baileybdog110-beep/apple-watch-tamagotchi/images/back.png

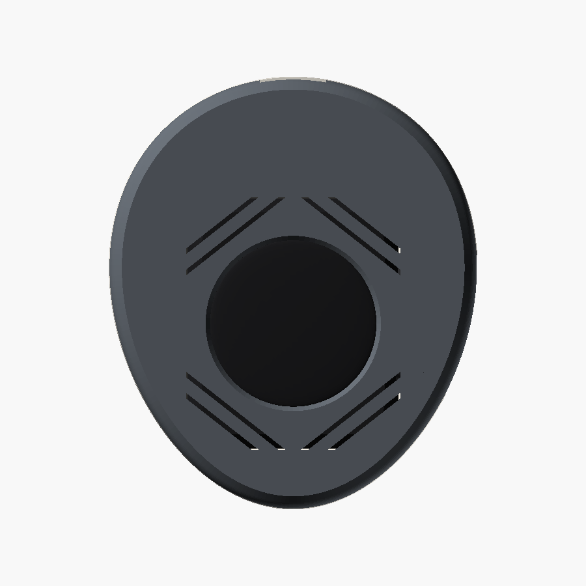
images/back.png
