baileybdog110-beep/apple-watch-tamagotchi/images/crown.png

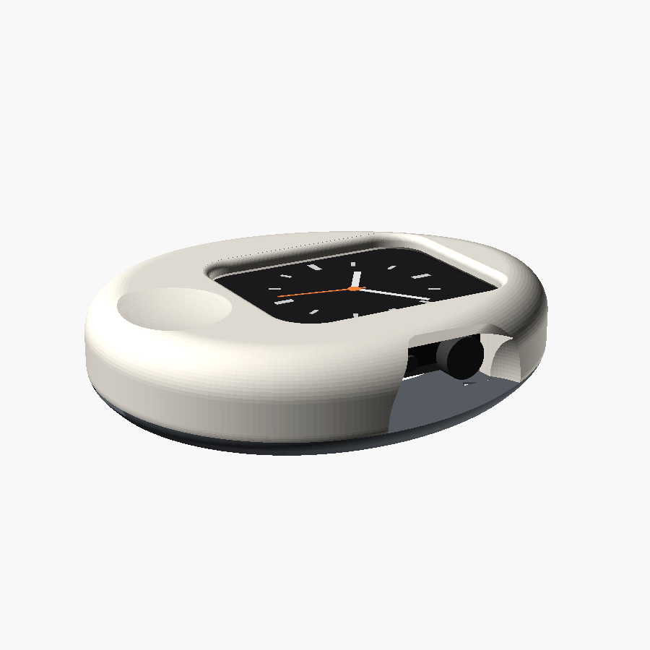
images/crown.png
