baileybdog110-beep/apple-watch-tamagotchi/images/exploded.png

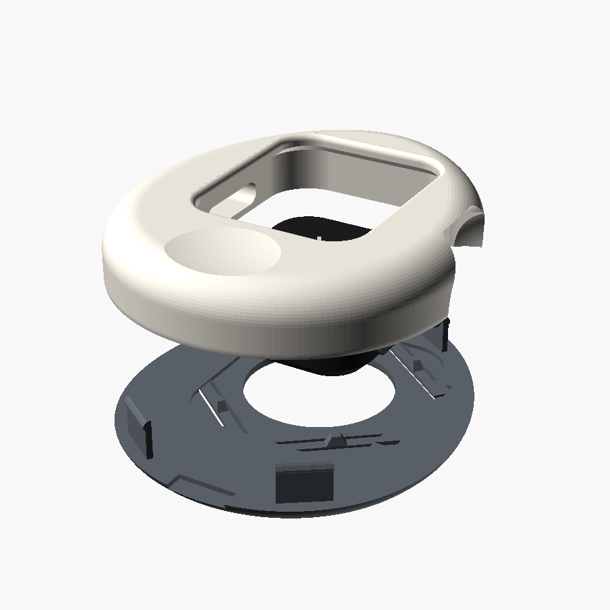
images/exploded.png
