baileybdog110-beep/apple-watch-tamagotchi/images/front.png

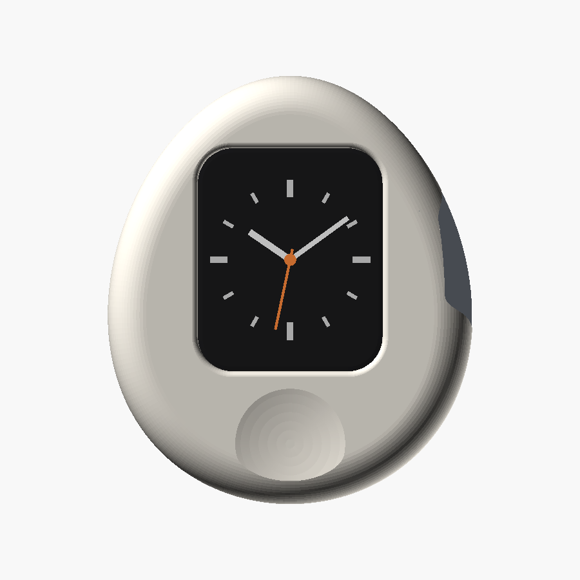
images/front.png
