baileybdog110-beep/apple-watch-tamagotchi/images/hero.png

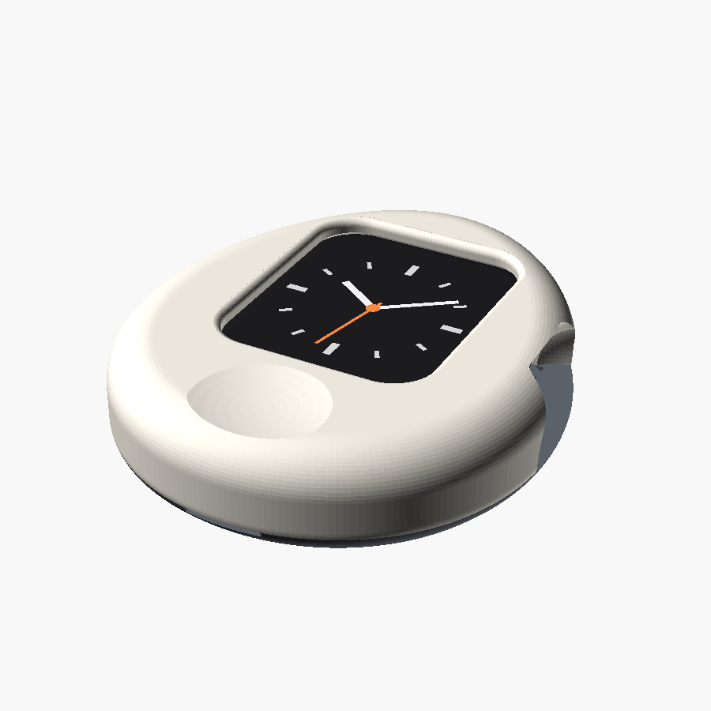
images/hero.png
