baileybdog110-beep/apple-watch-tamagotchi/images/profile.png

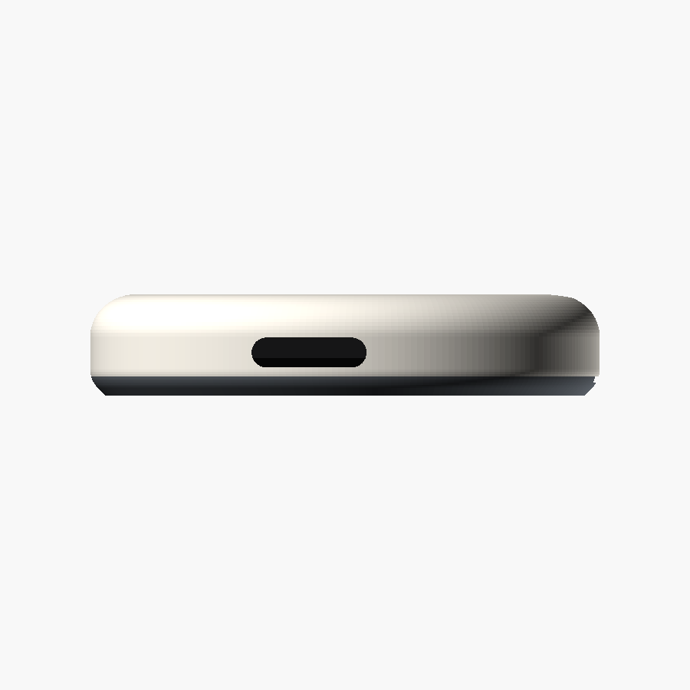
images/profile.png
