baileybdog110-beep/apple-watch-tamagotchi/images/sections.png

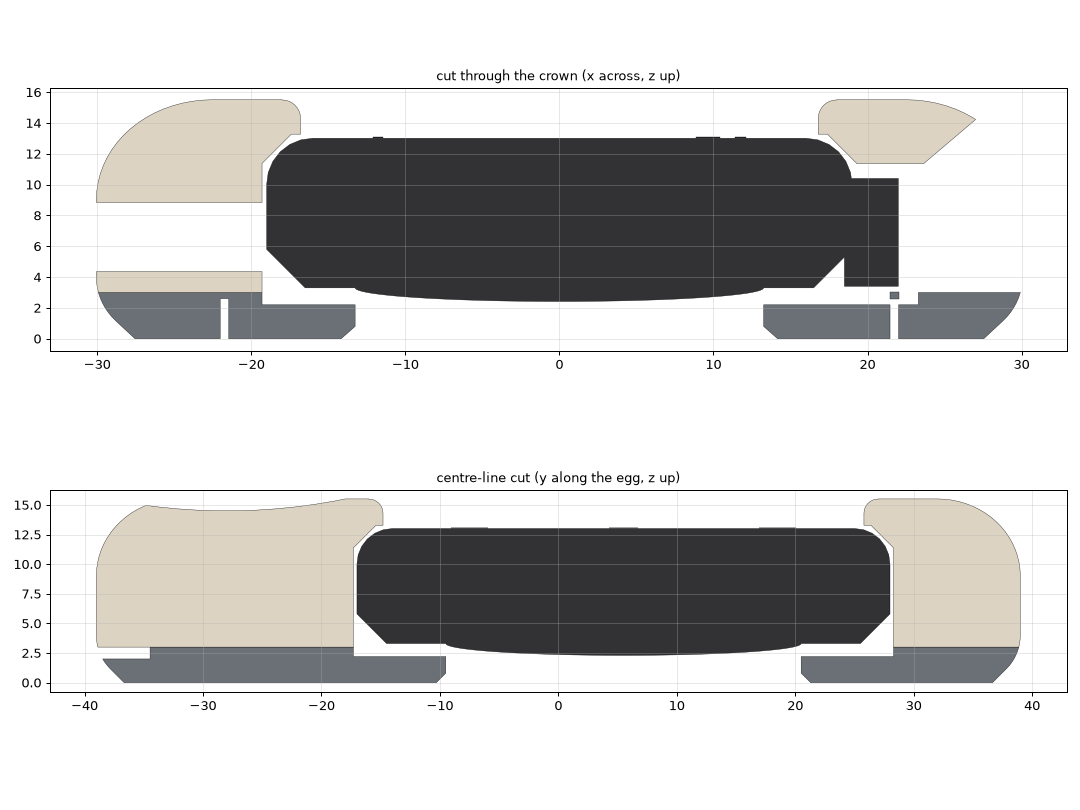
images/sections.png
