baileybdog110-beep/apple-watch-tamagotchi/3mf/egg_41mm_plate.3mf

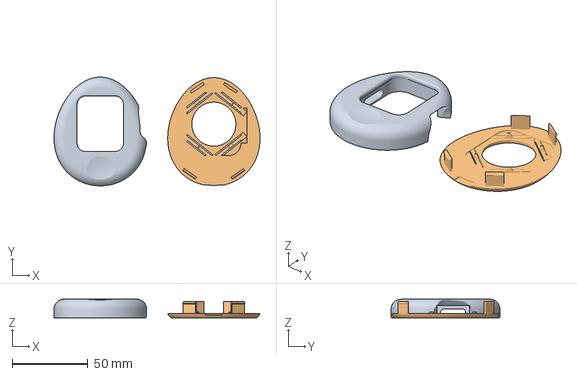
[picture p9: CAD file, 2026-10-06]
3mf/egg_41mm_plate.3mf
135.9 x 71.8 x 12.5 mm
back
