baileybdog110-beep/apple-watch-tamagotchi/stl/41mm/egg_41mm_back_looser.stl

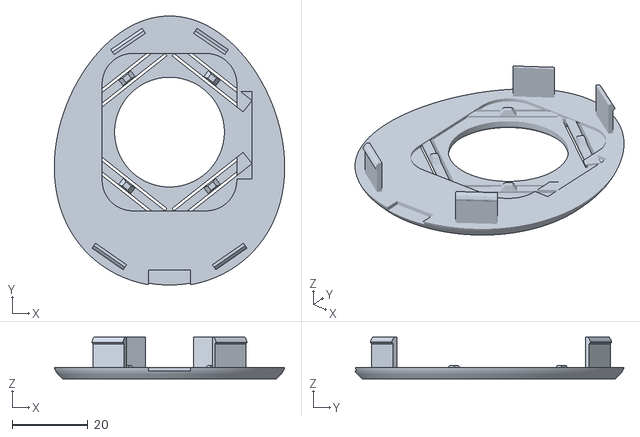
[picture p10: CAD file, 2026-10-06]
stl/41mm/egg_41mm_back_looser.stl
60.9 x 71.1 x 11.0
