baileybdog110-beep/apple-watch-tamagotchi/stl/45mm/egg_45mm_fit_test.stl

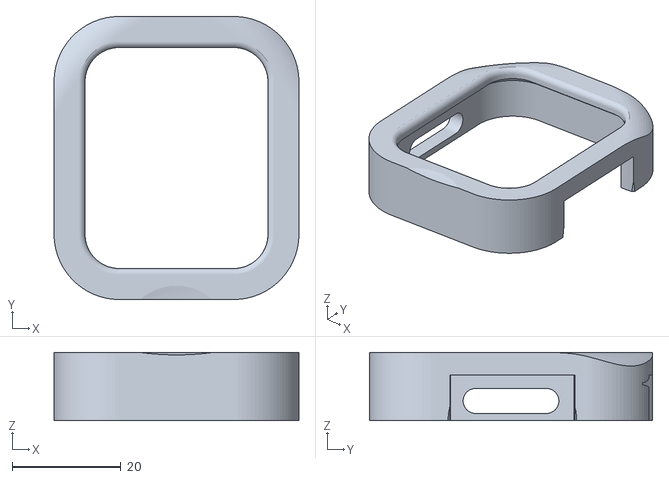
[picture p11: CAD file, 2026-10-06]
stl/45mm/egg_45mm_fit_test.stl
45.0 x 52.0 x 12.5
