baileybdog110-beep/apple-watch-tamagotchi/3mf/egg_45mm_plate.3mf

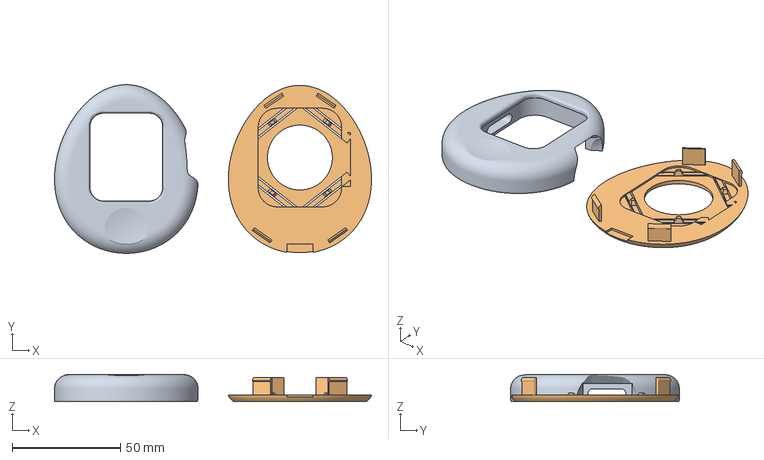
[picture p12: CAD file, 2026-10-06]
3mf/egg_45mm_plate.3mf
146.6 x 78.0 x 12.5 mm
back
