baileybdog110-beep/apple-watch-tamagotchi/stl/45mm/egg_45mm_back_tighter.stl

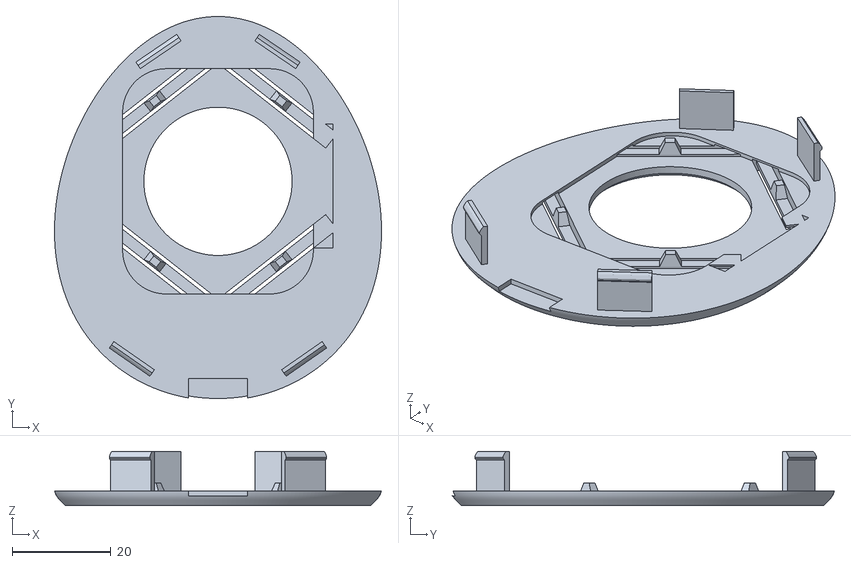
[picture p13: CAD file, 2026-10-06]
stl/45mm/egg_45mm_back_tighter.stl
66.2 x 77.3 x 11.0
