baileybdog110-beep/apple-watch-tamagotchi/stl/45mm/egg_45mm_shell.stl

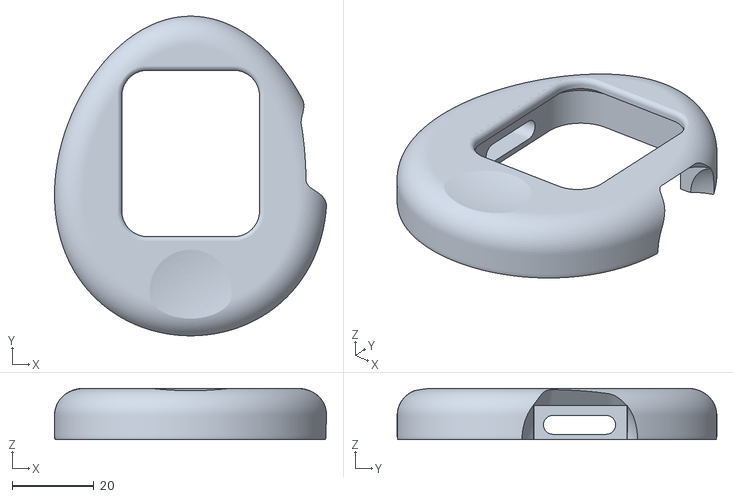
[picture p15: CAD file, 2026-10-06]
stl/45mm/egg_45mm_shell.stl
66.4 x 78.0 x 12.5
