baileybdog110-beep/apple-watch-tamagotchi/stl/41mm/egg_41mm_shell.stl

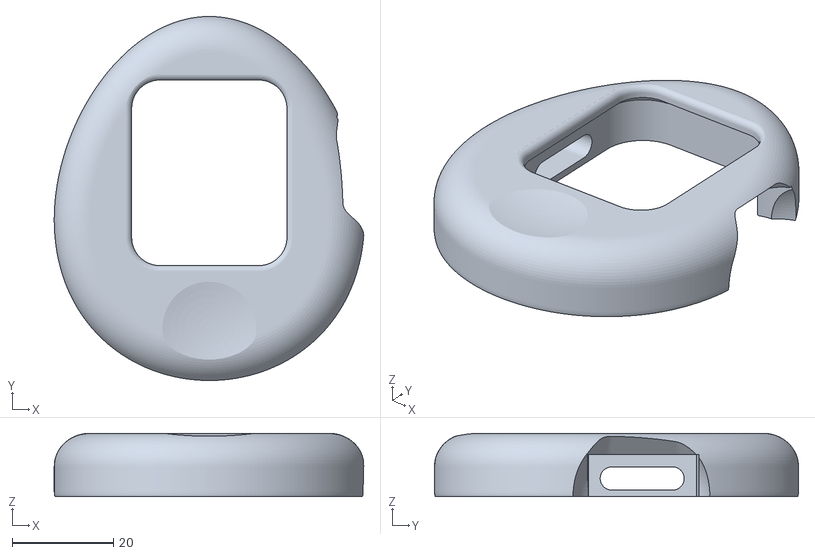
[picture p16: CAD file, 2026-10-06]
stl/41mm/egg_41mm_shell.stl
61.0 x 71.8 x 12.5
