baileybdog110-beep/apple-watch-tamagotchi/stl/41mm/egg_41mm_fit_test.stl

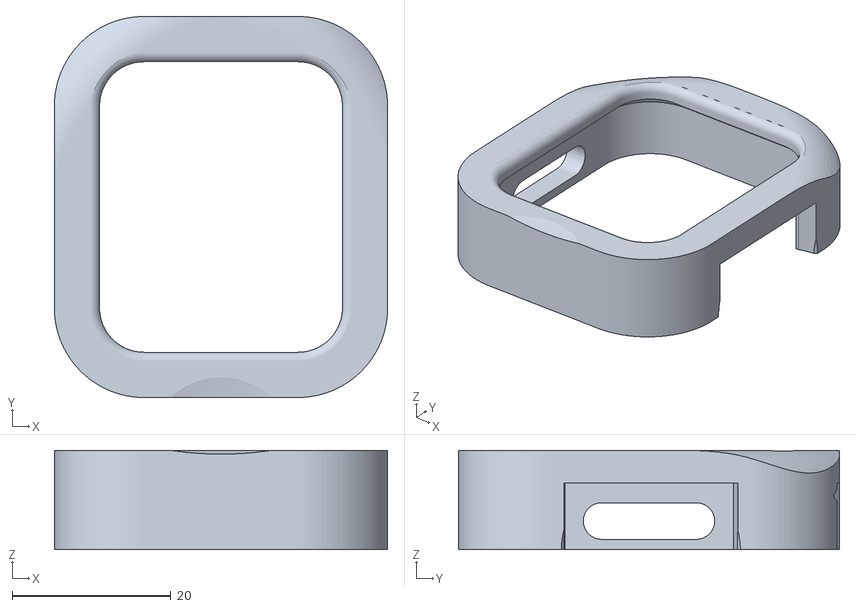
[picture p17: CAD file, 2026-10-06]
stl/41mm/egg_41mm_fit_test.stl
42.0 x 48.0 x 12.5
