baileybdog110-beep/apple-watch-tamagotchi/(list of files, cad)

Other CAD files:
stl/41mm/egg_41mm_back.stl
stl/45mm/egg_45mm_back.stl
stl/45mm/egg_45mm_back_looser.stl
